gurjevanbhatti/StormHacks2026/images/step2_esp32.png

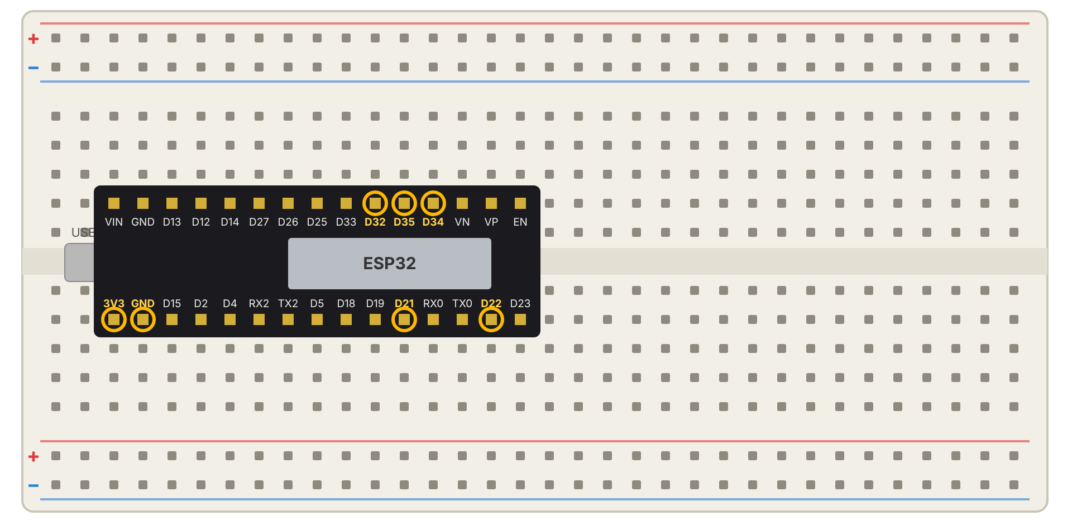
images/step2_esp32.png
