gurjevanbhatti/StormHacks2026/images/step3_power.png

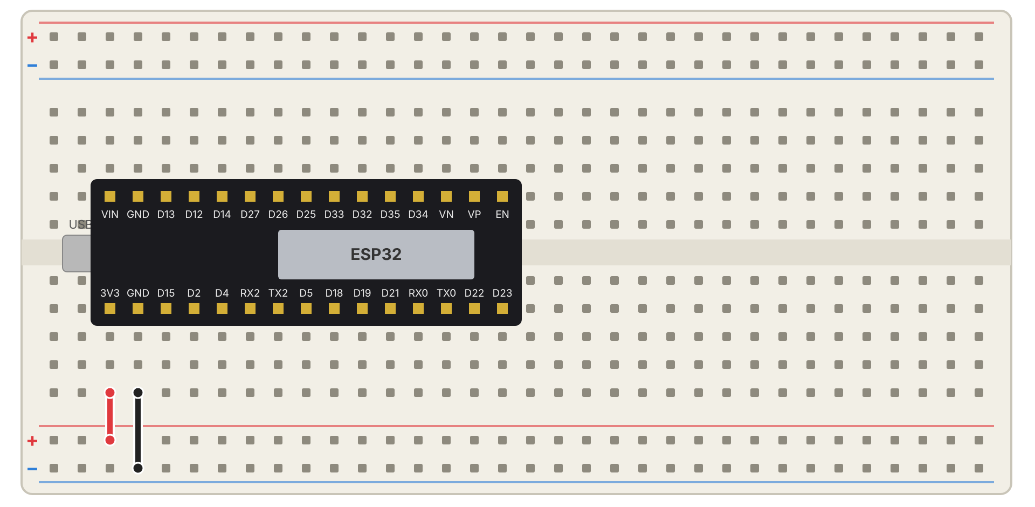
images/step3_power.png
