gurjevanbhatti/StormHacks2026/images/step4_mpu.png

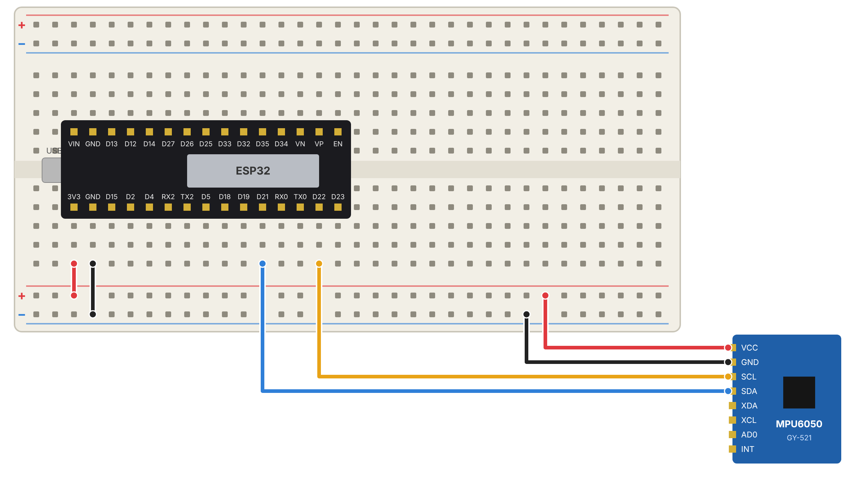
images/step4_mpu.png
