gurjevanbhatti/StormHacks2026/images/step7_battery.png

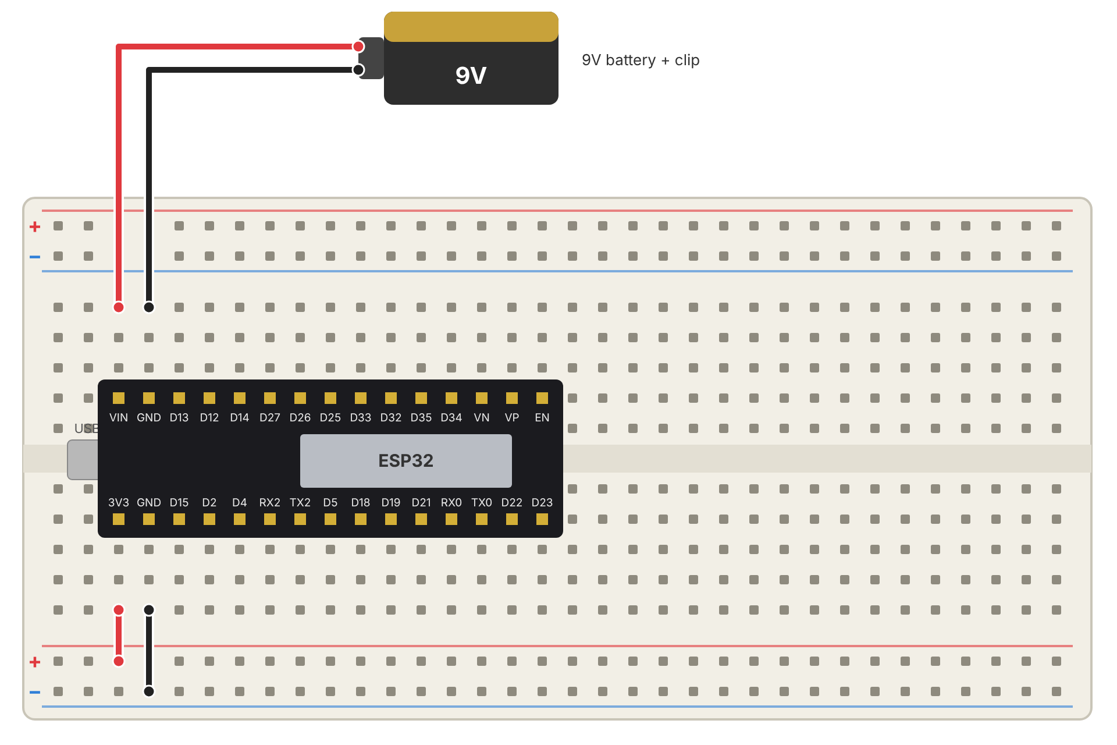
images/step7_battery.png
